Theo428/Arduino-Midi-Control-Panel/README/Schematic2.png

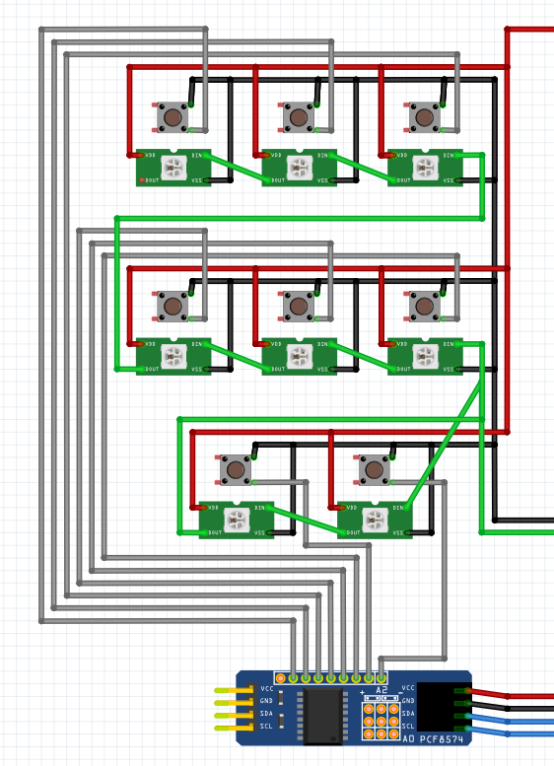
README/Schematic2.png
