Theo428/Arduino-Midi-Control-Panel/README/Schematic3.png

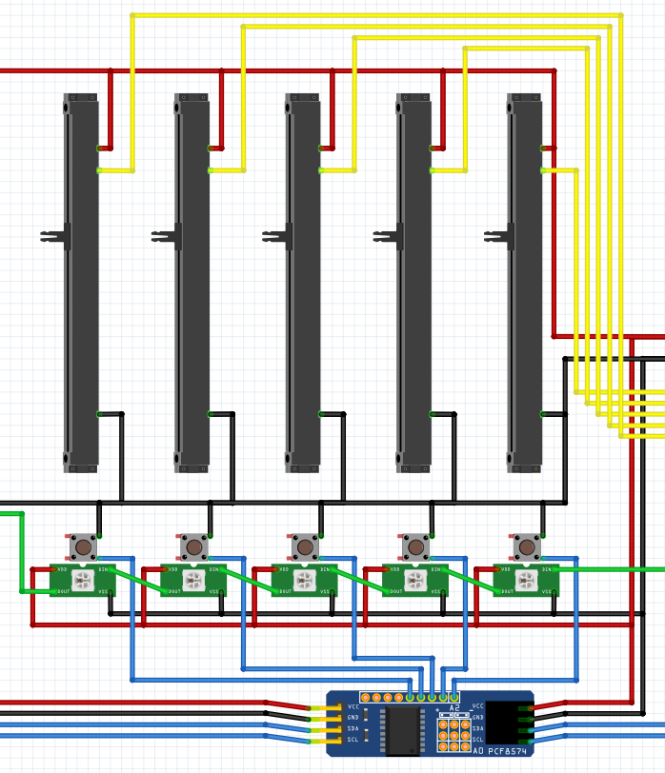
README/Schematic3.png
