Theo428/Arduino-Midi-Control-Panel/(commit log)

2022-03-02 added schematics and product images
2022-03-02 removed extra schematic images
2022-03-02 added fairly sad assembly instructions
    its like 12:40 here and im tired but want this to be done enough for now
